JLU-OSTA/Automatic_Sailboard_Control_System/Tree/GUI合格测试.png

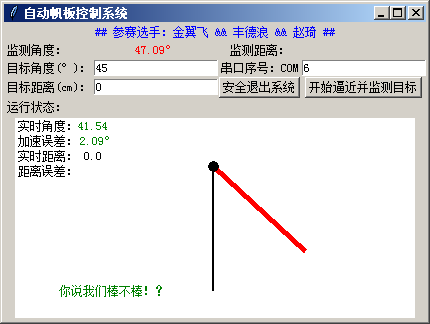
Tree/GUI合格测试.png
