JLU-OSTA/Automatic_Sailboard_Control_System/Tree/GUI格式错误.png

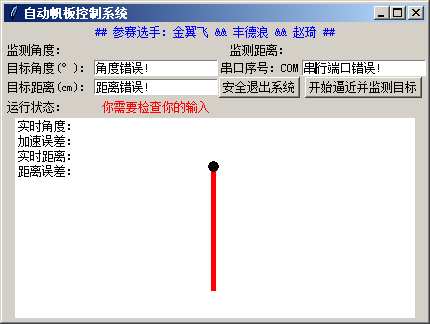
Tree/GUI格式错误.png
