JLU-OSTA/Automatic_Sailboard_Control_System/Tree/GUI调整过程误差大.png

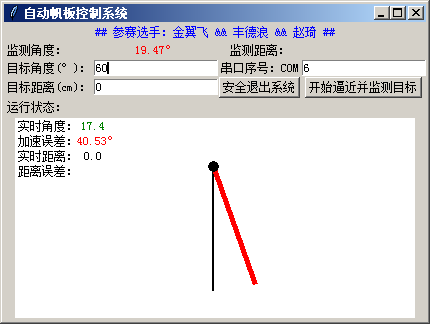
Tree/GUI调整过程误差大.png
