JLU-OSTA/Automatic_Sailboard_Control_System/Tree/检查.png

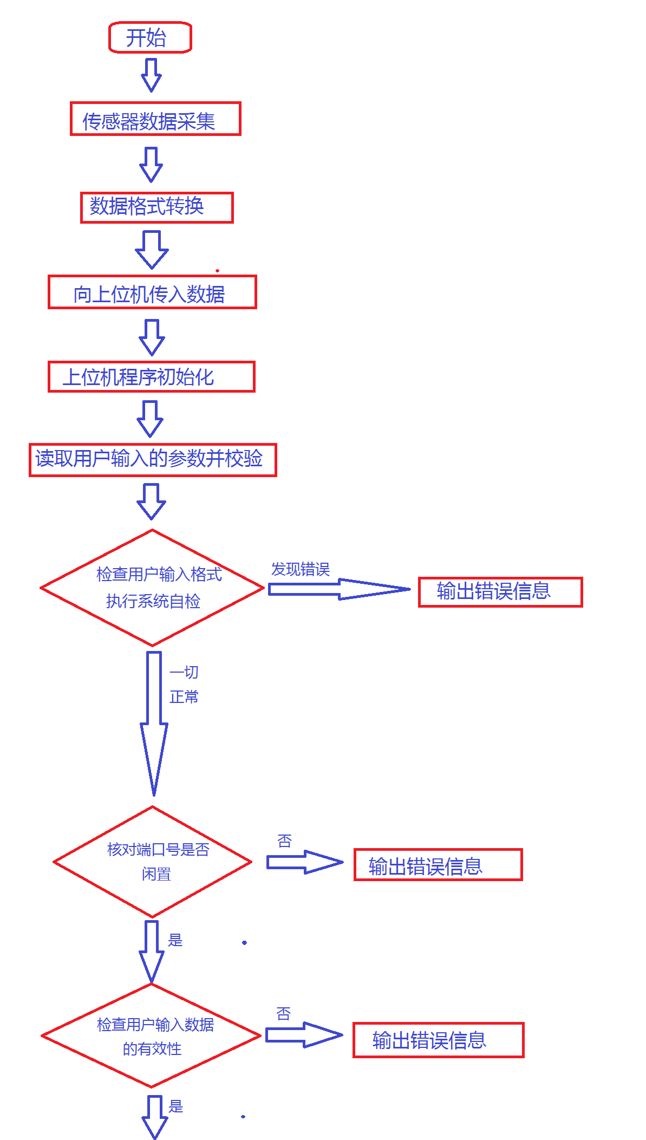
Tree/检查.png
