JLU-OSTA/Automatic_Sailboard_Control_System/Tree/调速.png

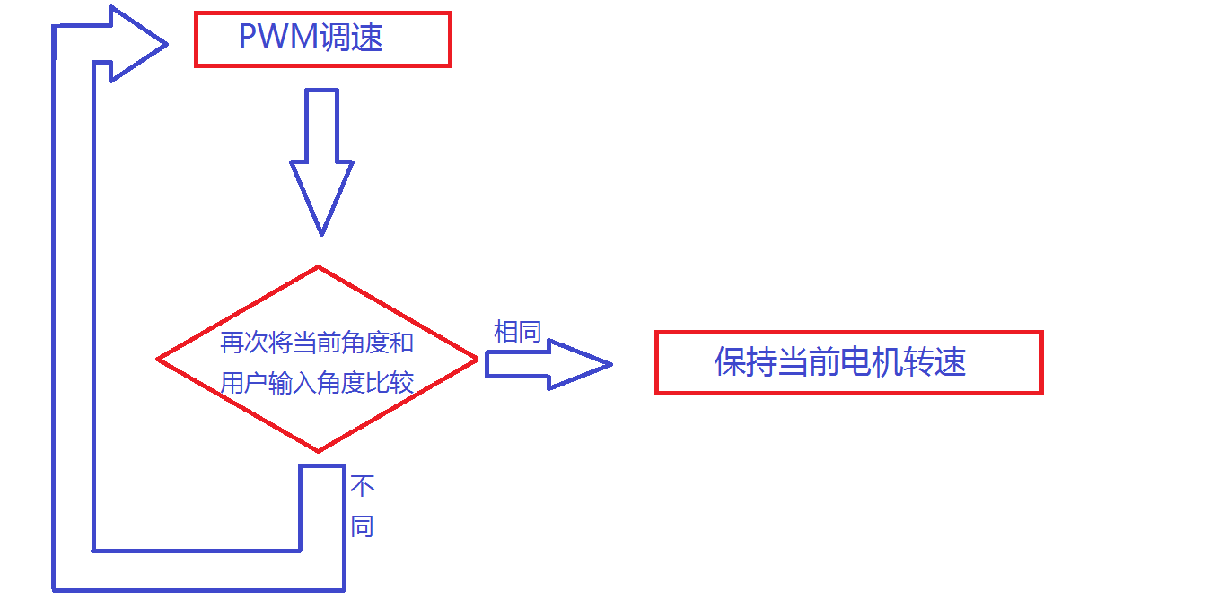
Tree/调速.png
