JLU-OSTA/Automatic_Sailboard_Control_System/Tree/运行.png

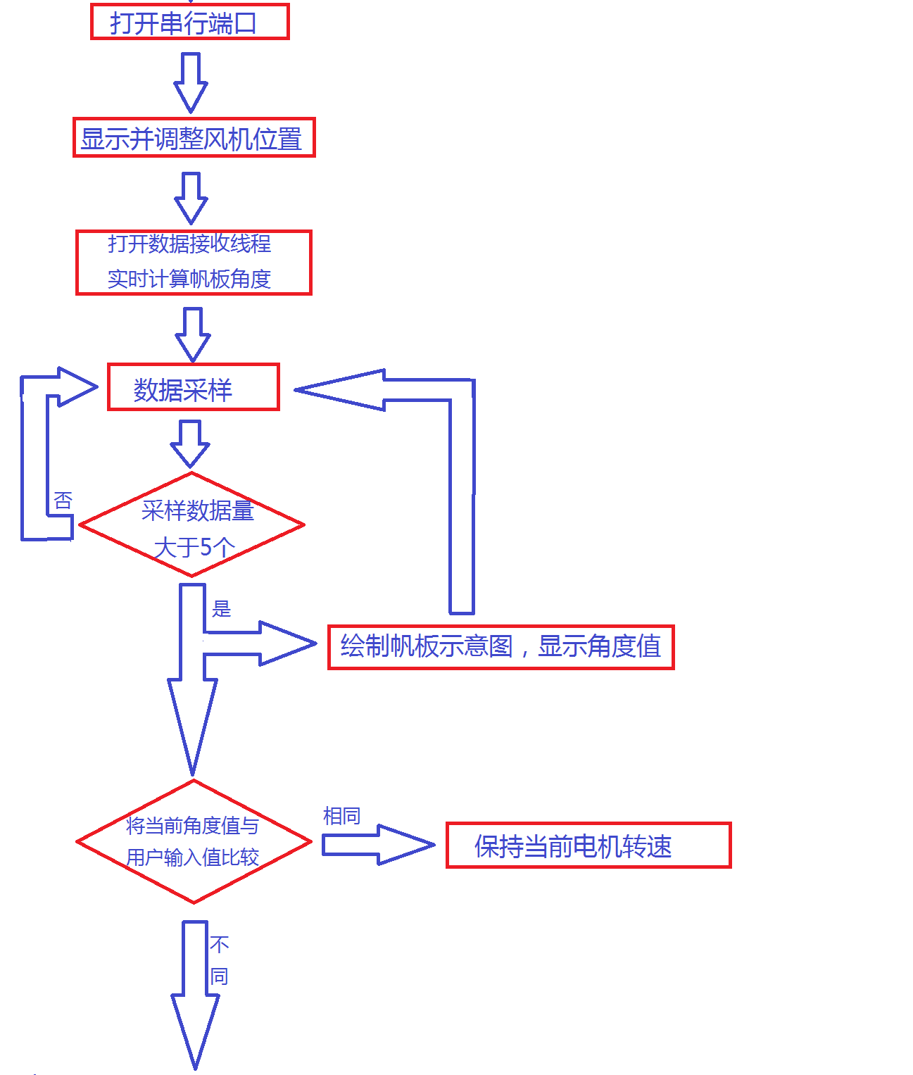
Tree/运行.png
