JLU-OSTA/Automatic_Sailboard_Control_System/(list of files, cad)

Other CAD files:
C_MCU_Cmd/mcu.OBJ
C_mcu_pwm/mcu_clk.OBJ
C_MCU_Cmd/STARTUP.OBJ
C_mcu_pwm/STARTUP.OBJ
